Nennala/CoopRobot/Spec/Terrain.odt

Spécification Epreuve

Objectifs

Chaque robot doit :

- Se repérer et repérer son coéquipier
- Rejoindre son coéquipier
- Traverser avec son coéquipier la zone de passage afin de valider l’épreuve

Terrain de jeu (80 * 80 cm)

Robot 1

Robot 2

Obstacle

Zone de passage
