Nennala/CoopRobot/Spec/coop robots.odt

Coopération de robots

Réaliser 2 robots sumo et les faire collaborer pour remplir une tache trop difficile pour 1 seul. Les robots doivent être identiques et doivent être équipés de capteurs afin d’appréhender leur environnement. Ils doivent pouvoir communiquer entre eux pour élaborer et exécuter leur stratégie.

# Intérets

Ce projet peut être vu comme un point de départ de projets sur l’étude de comportements collectifs (collaboration, competition). Des projets avec plus de robots peuvent émerger, comme la cartographie, des jeux (sports) où autre.

# Compétences principales mise en œuvre

- Robotique : Réalisation des robots (méca, installation des capteurs/actionneurs...)
- Informatique embarquée : programmation C des capteurs/actionneurs/communication
- Intelligence artificielle : Implémentation C d’un unique algorithme de collaboration
- Automatique : Régulation (ou estimation) de la position

# Cahier des charges

1. La première étape est de définir la mission à réaliser (exemple : pousser une caisse, tendre une corde, synchroniser des événements)
2. Designer les robots en conséquences : lister les actionneurs/capteurs nécessaires
3. Réalisation des 2 robots
4. Implémentation de l’algorithme unique à implémenter dans les robot
5. Intégration et tests
6. Réaliser une documentation permettant à d’autres de comprendre/reproduire/améliorer le projet

# Proposition de gestion de projet

Les taches 1 et 2 doit être réalisées en équipe. Puis les taches 3 et 4 peuvent être réalisées en parallèle car elles sont toutes les deux nécessaire pour la tache 5. La tache 6 doit être ouverte du début à la fin.

# Points évalués

- L’approche (démarche, organisation) : 40 %
- Le résultat final : 40 %
- La documentation : 20 %

# Pistes d’amélioration

- Améliorer les robots : précision des capteurs/actionneurs, performance/robustesse de l’automatique
- Etude d’autres stratégies, avec plus de robots par exemple
- Ajout d’un robot perturbateur
