Nennala/CoopRobot/Spec/présentation_projet.odt

Coopération de robots

## Système centralisé/décentralisé

Dans un système centralisé, un ordinateur calcule toutes les actions de chaque exécuteur (robot) et les transmets à ces derniers qui les exécutent. À l'inverse, dans un système décentralisé c'est le comportement de chaque robot qui défini le comportement global.

Nous ne somme pas dans le cas d'un système centralisé car chaque robot participe à la réflexion et reste libre du choix de ses actions. Absence de relation maître-esclave. Nous ne somme pas non plus dans un système décentralisé car ce n'est pas le comportement de nos robots qui définis un comportement global car il n'y a pas de comportement global attendu. Nous somme dans un cas de coopération, chaque robot prend les décisions le concernant lui même mais il tiens compte de l'état de son coéquipier.

## Mise en place de la coopération

Sur notre terrain la coopération intervient lors de la détermination de la position. Nous avons en effet deux robots évoluant sur une même surface, ils vont donc se gêner l'un l'autre car ils peuvent fausser les mesurer de leur coéquipier, cependant on peut aussi voir cela comme un avantage :

### Trois utilisations possibles de la communication

- Mise en commun des capteurs → faire mesurer de la vitesse d'un robot par un autre
- Mise en commun des actionneurs → déplacement d'un robot afin de valoriser l'information du second
- Mise en commun des informations → échange de positionnement, avancement des objectifs

## Mise en place de la coopération : 3 possibilités

1 – Le robot 1 bouge, détermine sa position, puis le robot 2 bouge, détermine sa position, alors les deux robots se rejoignent et réalisent l'action commune.

  - Mise en commun des informations

2 – Le robot 1 bouge, détermine sa position, détermine la position du robot 2 puis les deux réalisent l'action commune

  - Mise en commun des capteurs

3 – Les deux robots se déplacent en même temps, déterminent leur position et coopèrent afin de vérifier ce positionnement. Puis ils réalisent l'action commune.

  - Mise en commun des informations
  - Mise en commun des capteurs

# Cahier des charges

1. La première étape est de définir la mission à réaliser (exemple : pousser une caisse, tendre une corde, synchroniser des événements)
2. Designer les robots en conséquences : lister les actionneurs/capteurs nécessaires
3. Réalisation des 2 robots
4. Implémentation de l’algorithme unique à implémenter dans les robot
5. Intégration et tests
6. Réaliser une documentation permettant à d’autres de comprendre/reproduire/améliorer le projet

# Compétences principales mise en œuvre

8. Robotique : Réalisation des robots (méca, installation des capteurs/actionneurs...)
9. Informatique embarquée : programmation C des capteurs/actionneurs/communication
10. Intelligence artificielle : Implémentation C d’un unique algorithme de collaboration
11. Automatique : Régulation (ou estimation) de la position
