Nennala/CoopRobot/Spec/spécification.odt

Spécification

Coopération de robots

L’objectif de ce projet est de créer deux robots capables de coopérer pour venir à bout d’une épreuve définie qui oblige une coopération.

Le robot doit être capable de :

- Se déplacer
- Se repérer dans l’espace
- Communiquer avec son coéquipier
- Prendre une décision en concertation avec son coéquipier

# Spécification matérielle du robot :

Les châssis des robots sont fournis au projet, ainsi que les composants et capteurs. Les robots doivent être identiques en conception matérielle.

## Micro-contrôleur :

Pour ce projet nous utiliserons deux cartes STM32F303K8 comme micro-contrôleurs pour nos robots, ces cartes permettent un encombrement minimal sur le robot et fournissent suffisamment d’entrées-sorties pour nos différents capteurs.

## Déplacement :

Le déplacement est assuré par des moteurs à courant continus. Un driver moteur (nom du driver) fait l'interface de puissance.

Pour pivoter il est également important de connaître son orientation. En effet sans orientation connue notre robot est sensible aux perturbations externes. Nous utiliserons donc ici un magnétomètre pour connaître l’orientation de notre robot.

## Repérage dans l’espace :

Ici deux capteurs SHARP seront utilisés pour mesurer les distances. L’un d’entre eux sera fixé sur un servomoteur fixé sur le châssis pour pouvoir balayer l’environnement et l’autre sera fixe, dirigé vers l’avant du robot.

## Communication :

Pour la communication, le protocole UART sera utilisé mais la communication filaire est trop contraignante sur une épreuve (risques d’accrocher les fils dans le décors et risque de perturbations avec la longueur du fil) ce sont donc deux modules radio à sens unique qui seront utilisés.

# Spécification logicielle :

La conception logicielle est séparée en trois parties :

- Une couche bas niveau avec des fonctions permettant de déplacer le robot et de récupérer les valeurs des capteurs
- Un protocole de communication gérant le transfert de données de manière fiable.
- Une couche haut niveau définissant le comportement du robot.

La couche haut niveau se servira des fonctions des deux autres niveaux pour définir des réactions pour le robots en fonction des données matérielles.

## Couche bas niveau:

Le but de cette couche est de créer des fonctions élémentaires de déplacement à l’aide de capteurs et des timers pour avancer et tourner, ainsi qu’une fonction renvoyant une structure contenant les valeurs des capteurs la plus à jour possible (100 fois par secondes).

Fonctions élémentaires pour le déplacement :

- avancer de 10 cm
- reculer de 10 cm
- tourner de 90° à gauche
- tourner de 90° à droite

## Couche communication :

Cette couche doit gérer indépendamment du reste la communication entre les deux robots, elle définie donc la taille des trames envoyées et le protocole de sécurité des données pour vérifier l’intégrité de celui-ci. Il y a plusieurs choix technologiques possibles que nous devons tester en fonction de la longueur de la trame :

- bit de parité
- XOR
- Checksum

## Couche IA :

Cette couche définie la connaissance de l’épreuve du robot ainsi que la façon que celui-ci aura de quadriller son environnement. Cette couche utilise toutes les fonctions des couches inférieure et donc se positionne en couche de haut niveau. Elle permet de créer les déplacement du robots en fonctions de son environnement, de définir comment celui-ci va repérer où est le deuxième robot et également quelle méthode de prise de décision ceux-ci vont utiliser.

Quadrillage de la zone :

On utilise le fait que les fonctions élémentaires font avancer de 10 cm pour quadriller la zone en une multitude de carrés de 10*10 cm² pour établir une carte de l’épreuve.

Repérage du deuxième robot :

Les robots vont se déplacer en balayant la zone en cherchant un déplacement anormal qui ne soit pas de 10 cm, s’ils ne se trouvent toujours pas, il vont tourner pour chercher dans une autre direction.

Prise de décision :

Pour la prise de décision les robots vont utiliser un tirage pseudo aléatoire et comparer les numéros obtenus, celui qui a le numéro le plus grand deviens prioritaire et indique à l’autre qu’il est prioritaire.
