Nennala/CoopRobot/Dossier technique/soutenance.odp

## Coopération de robots

Thibault Vernay, Victor Cazaux, Daphné Porteries

## Objectifs

Robots capables de :

- Se déplacer
- Se repérer dans l’espace
- Communiquer avec un coéquipier
- Prendre une décision en concertation

## Présentation de l’épreuve

Robot 1

Robot 2

Obstacle

Zone de passage

## Organisation interne

- Mise en place d’un dépôt GitHub
- Schéma d’organisation :

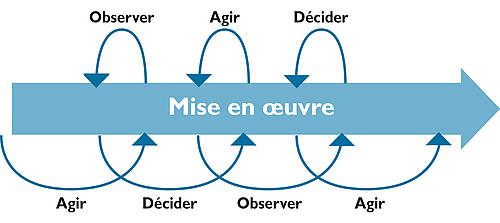
[picture p15: figure]

## Premier jet

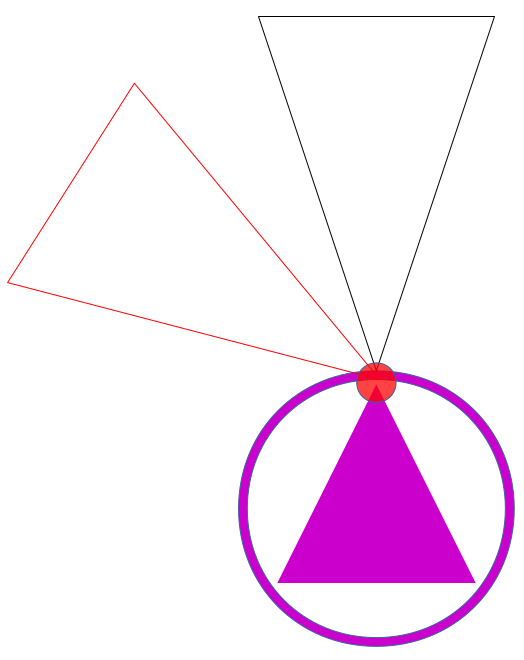
[picture p16: figure]

O

N

E

S

## LE robot

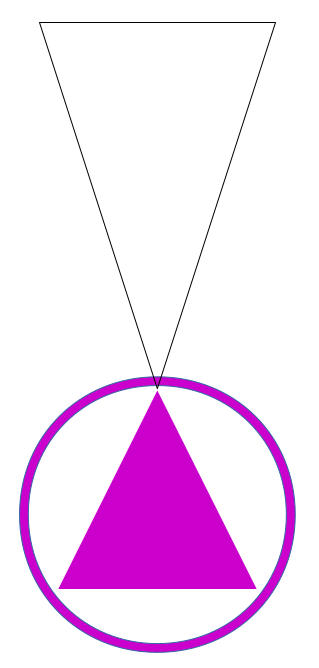
[picture p17: figure]

## Spécification matérielle

- Matériel à disposition :
- Châssis imprimé 3D
- Moteurs courant continu
- Servomoteur

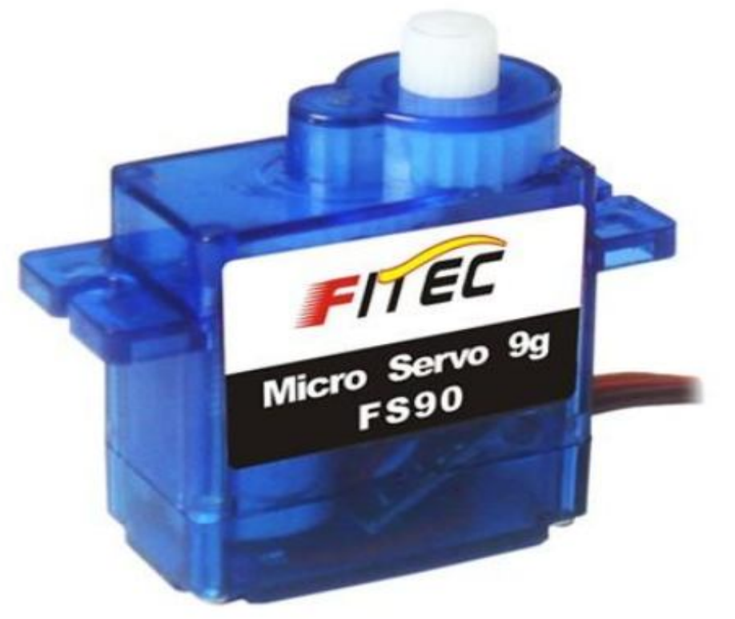
[picture p18: figure]

## Spécification matérielle

- Repérage dans l’espace :
- Magnétomètre
- Capteurs IR

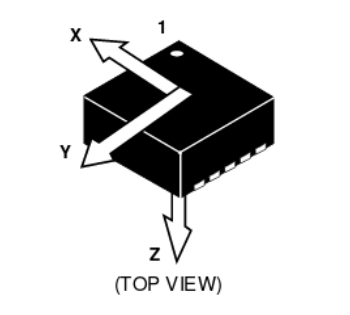
[picture p19: figure]
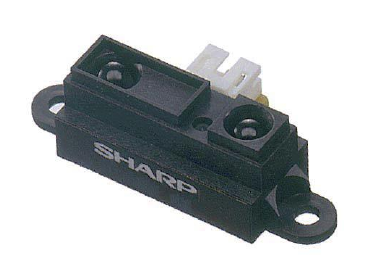
[picture p20: figure]

## Spécification matérielle

- Communication :
- UART filaire
- Module radio ?

## Spécification matérielle

- Montage d’alimentation :

Vin

5V

GND

C1

C2

C3

C4

## Le micro-contrôleur

- Nucléo :

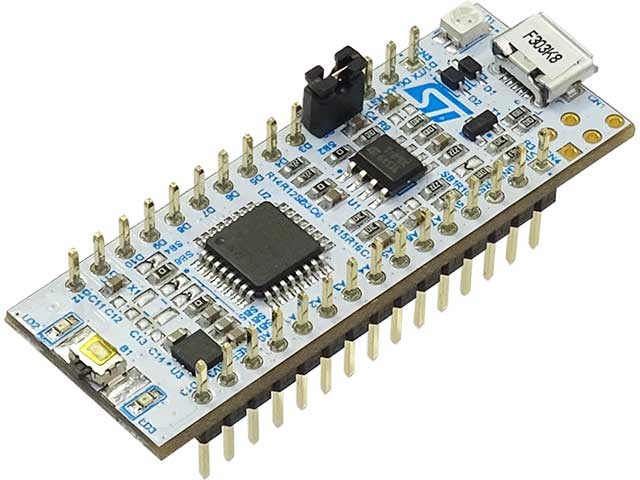
[picture p21: figure]

STM32F303K8

## Présentation de la HAL

- Hardware Abstraction Layout

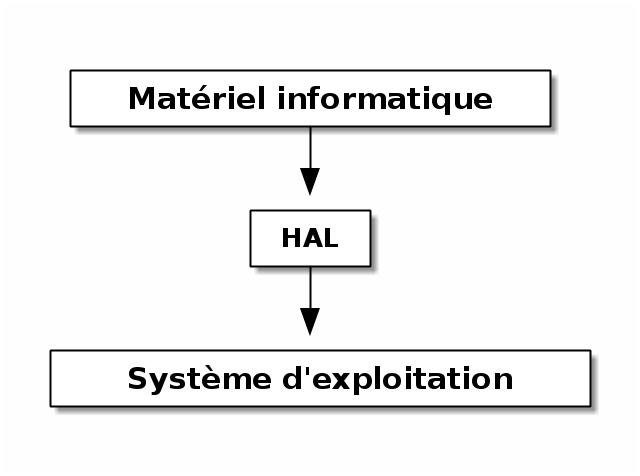
[picture p22: figure]

## Spécification logicielle

- Découpage du projet

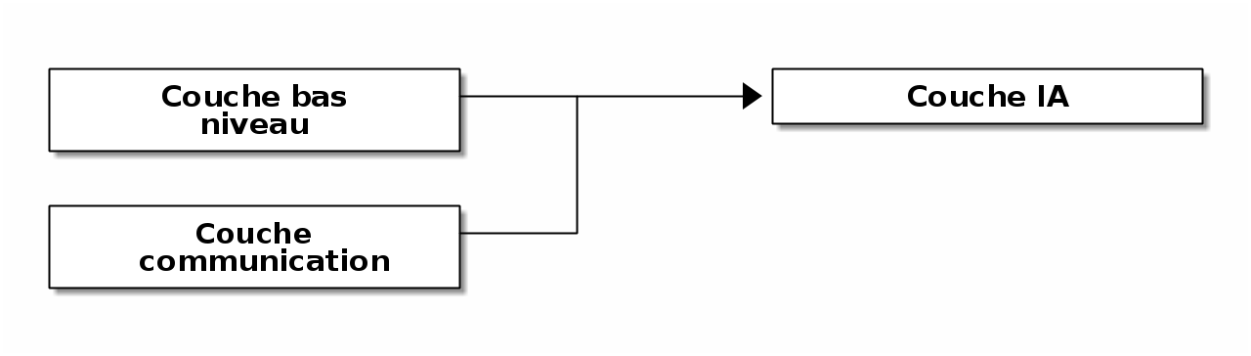
[picture p23: figure]

## Étude des composants

- Moteurs courant continu :
- Driver moteur TB6612FNG

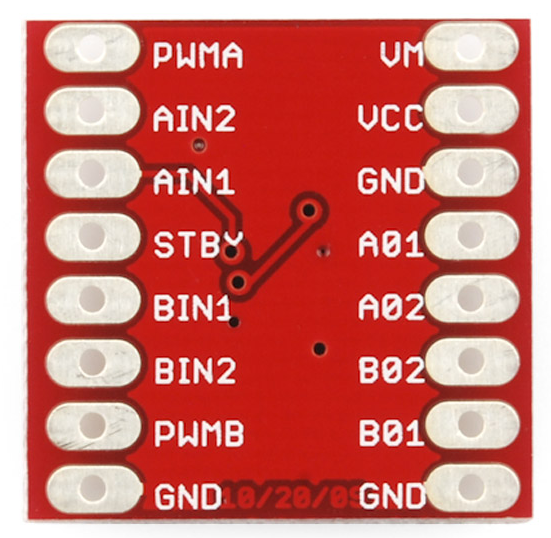
[picture p24: figure]

## Étude logicielle

- Moteurs

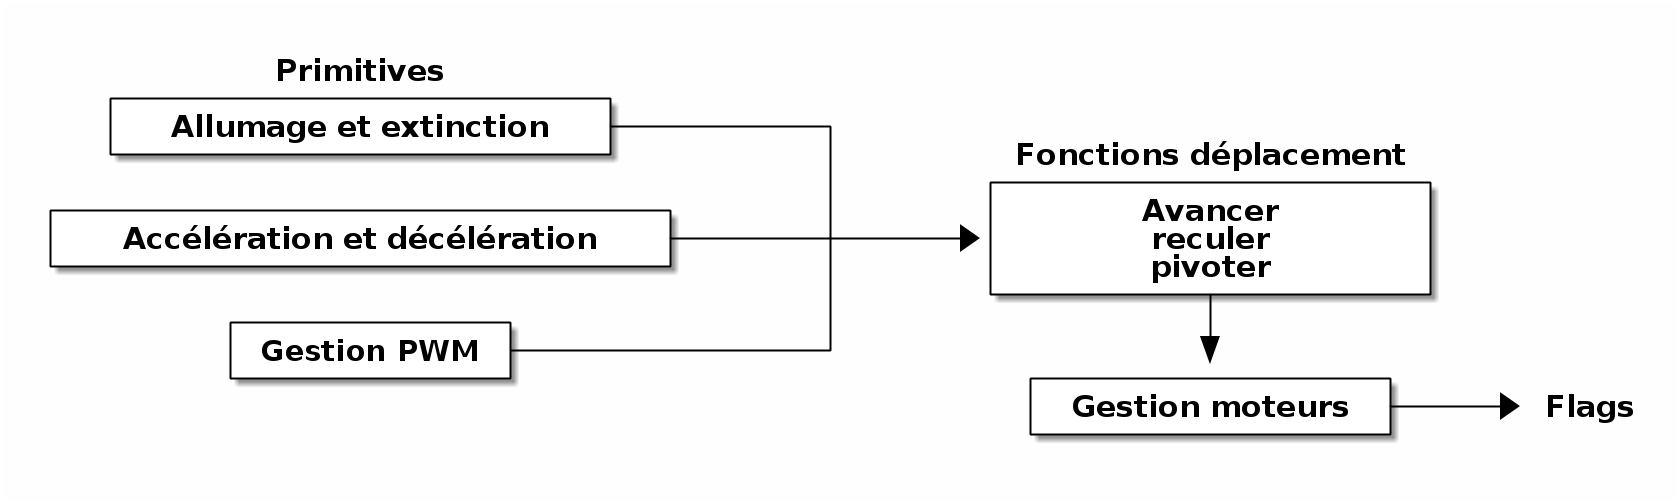
[picture p25: figure]

## Étude des composants

- Capteur IR :
- Capteur de distance à LED infrarouges de 10 cm à 80 cm


## Étude logicielle

- ADC avec interruptions :

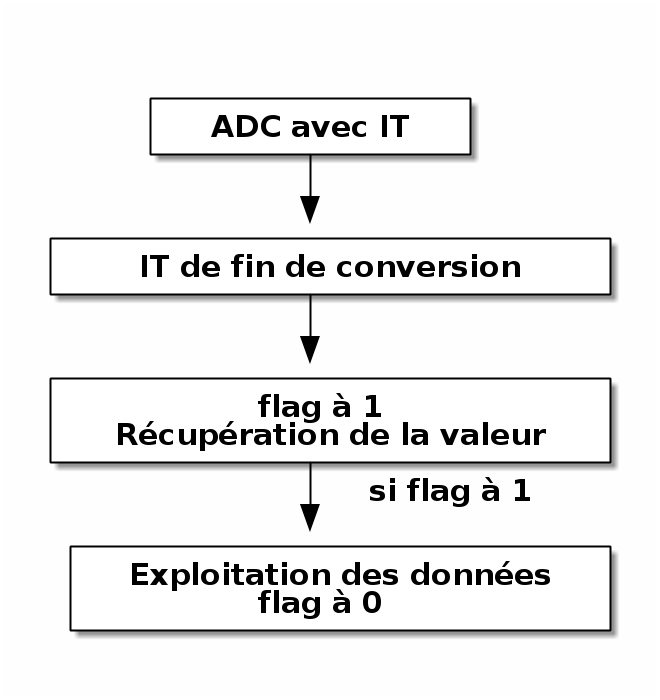
[picture p26: figure]

## Étude logicielle

- Protocole d’envoi de données :

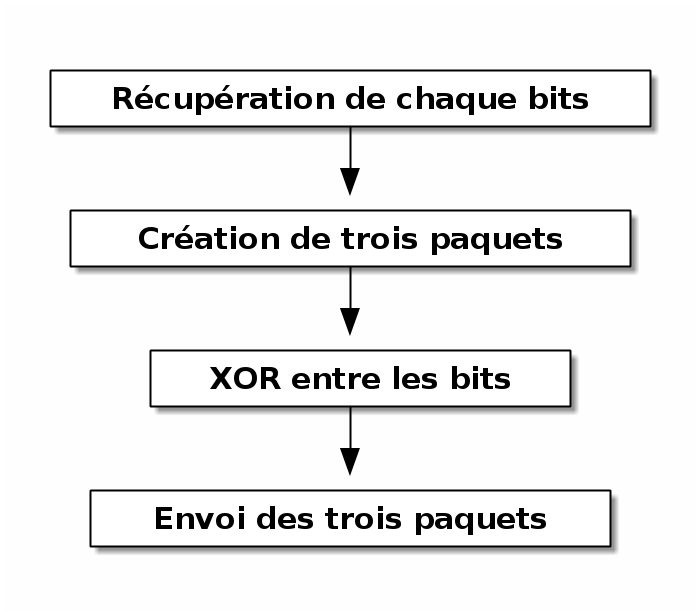
[picture p27: figure]

## Étude logicielle

- Protocole de réception de données :

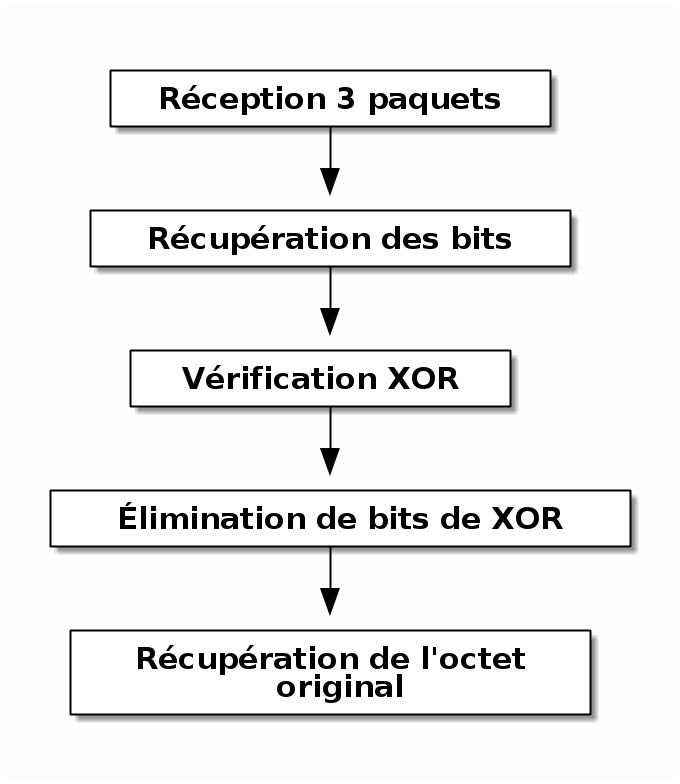
[picture p28: figure]

## Présentation FreeRTOS

- OS temps réel
- Parallélisation des processus
- Nombre de tâches limité par le matériel

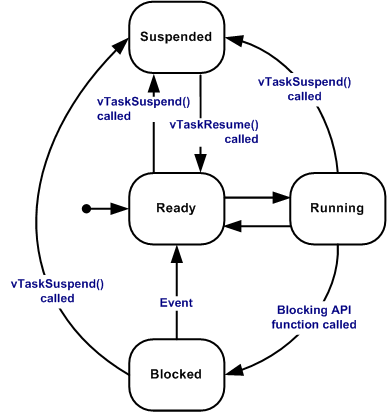
[picture p29: figure]

## Gestion de la mémoire

- Allocation de la stack
- Gestion du Heap

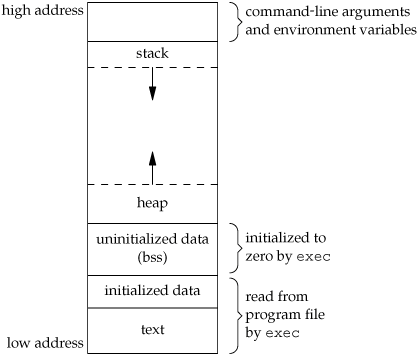
[picture p30: figure]

## Utilisation du FreeRTOS

Moteurs_task

IA_task

Flag_distance = 0

Flag_deplacement_fini = 0

## Utilisation du FreeRTOS

Moteurs_task

Déplacement de 3

Attendre la fin du

Déplacement

IA_task

Flag_distance = 0

Flag_deplacement_fini = 0

## Utilisation du FreeRTOS

Moteurs_task

Déplacement de 2

Attendre la fin du

Déplacement

IA_task

Flag_distance = 0

Flag_deplacement_fini = 0

## Utilisation du FreeRTOS

Moteurs_task

Déplacement de 2

Attendre la fin du

Déplacement

IA_task

Flag_distance = 2

Flag_deplacement_fini = 0

## Utilisation du FreeRTOS

Moteurs_task

Fais avancer le robot de 1

Décrémente le flag_distance de 1

Déplacement de 3

Déplacement de 2

Attendre la fin du

Déplacement

IA_task

Flag_distance = 2

Flag_deplacement_fini = 0

## Utilisation du FreeRTOS

Moteurs_task

Fais avancer le robot de 1

Décrémente le flag_distance de 1

Déplacement de 3

Déplacement de 2

Attendre la fin du

Déplacement

IA_task

Flag_distance = 1

Flag_deplacement_fini = 0

## Utilisation du FreeRTOS

Moteurs_task

Fais avancer le robot de 1

Décrémente le flag_distance de 1

Déplacement de 3

Déplacement de 2

Attendre la fin du

Déplacement

IA_task

Flag_distance = 1

Flag_deplacement_fini = 0

## Utilisation du FreeRTOS

Moteurs_task

Fais avancer le robot de 1

Décrémente le flag_distance de 1

Déplacement de 3

Déplacement de 2

Attendre la fin du

Déplacement

IA_task

Flag_distance = 0

Flag_deplacement_fini = 0

## Utilisation du FreeRTOS

Moteurs_task

Fais avancer le robot de 1

Décrémente le flag_distance de 1

Déplacement de 3

Déplacement de 2

Attendre la fin du

Déplacement

IA_task

Flag_distance = 0

Flag_deplacement_fini = 1

## Utilisation du FreeRTOS

Moteurs_task

Fais avancer le robot de 1

Décrémente le flag_distance de 1

Déplacement de 3

Déplacement de 3

Attendre la fin du

Déplacement

IA_task

Flag_distance = 2

Flag_deplacement_fini = 0

## Prise de décision

- Simulateur
- Pas totalement implémentée

## IA

## IA

## IA

## IA

Je ne suis pas dans un coin

## IA

## IA

## IA

## IA

## IA

Je suis dans un coin

## IA

Je suis dans un coin

## IA

Je suis dans un coin

## IA

N

O

E

S

## IA

RDV au Nord

N

O

E

S

OK, j’arrive

## IA

N

O

E

S

## IA

N

O

E

S

## IA

N

O

E

S

## IA

N

O

E

S

## IA

N

O

E

S

FINI !

## IA

## IA

## IA

## IA

Je suis au coin N-E

Je suis au coin N-E

## IA

Je te vois !

Je ne te vois pas !

## IA

Je suis dans le coin

## Problèmes rencontrés

- Complexification inutile
- Prise en main des outils
- Pas de magnétomètres

## Conclusion

- Compétences acquises
- Adaptation
- Travail de groupe
- Répartition des taches
