Nennala/CoopRobot/Spec/robot_final.pdf

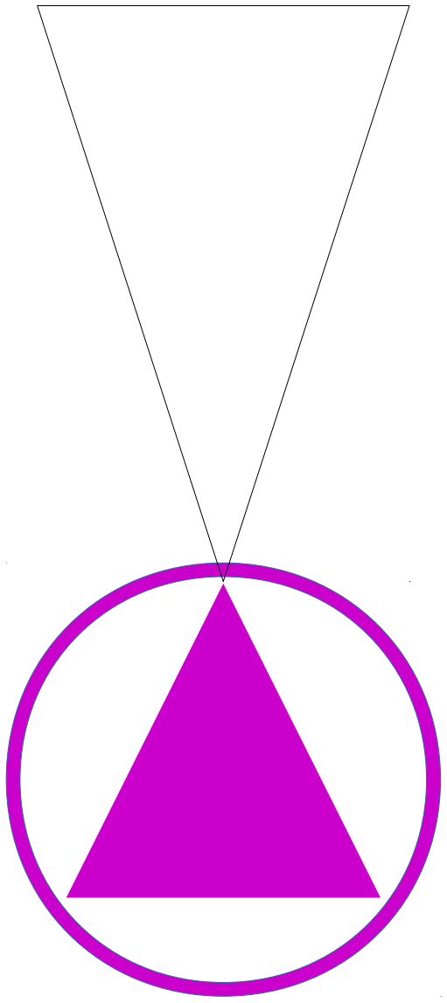
[picture p31: figure]
