Nennala/CoopRobot/Spec/robot_initial.pdf

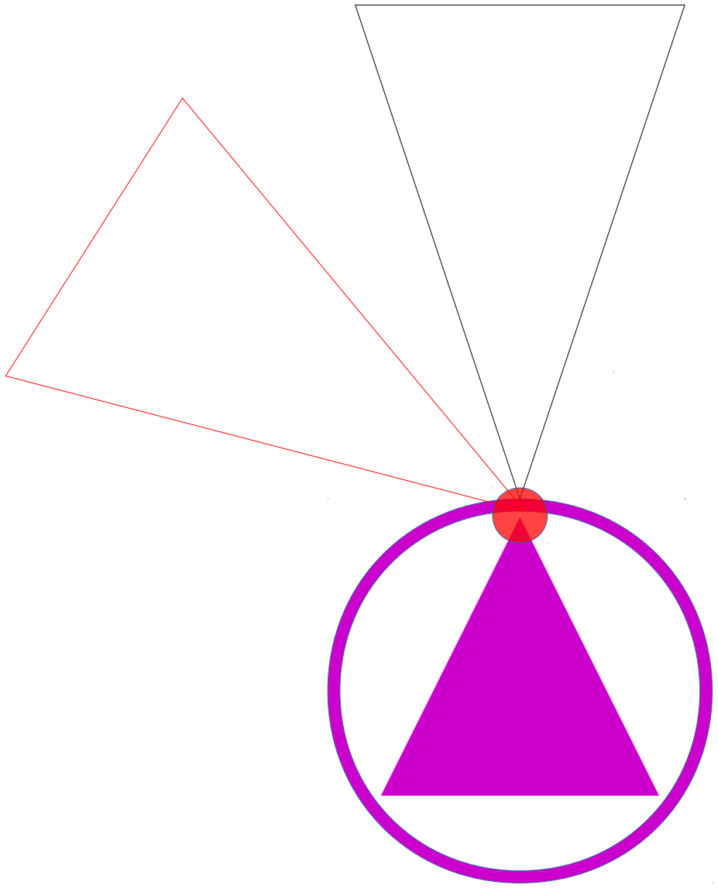
[picture p32: figure]
