Nennala/CoopRobot/Spec/Liste-miniprojets-2A.ods

Liste élèves 2A | Sujet 1
ADAMCZAK Nowen | Égaliseur Audio
BEAUTHIAS--VECCHIATO Antonin | Panneau solaire
BEYNEIX Alexis | Serre automatisée
BLANC-DOUGADOS Oriane | Panneau solaire
BLIN Alan | Panneau solaire
BOLLARD Guillaume | Panneau solaire
CAZAUX Victor | coop robot
COHENNEC Clara | Robot coureur
COSTAGLIOLA Guillaume | Robot coureur
CUGNET Théophile | Robot coureur
DAL PRA Etienne | Serre automatisée
DEMILLY Clément | Serre automatisée
DERANSART Erwan | Coop robot (IR)
DESBOS Luc | Serre automatisée
DREVET Elie | seagway
ECK Rémy | Asservissement balle
JOUD Raphaël | Serre automatisée
LE POURSOT Axelle | Seagway
LEROY Benjamin | Seagway
LONGERE Arthur | seagway
LOPES DA SILVA Thomas | Égaliseur Audio
MAIRE William | Égaliseur Audio
NALPAS-RIBIER Noémie | Panneau solaire
NGUYEN Jessica | seagway
NICOLUSSI CASTELLAN Guillaume | IR
PORTERIES Daphné | Coop robot
RIVIERE Anthony | Panneau solaire
ROSNOBLET Mathieu | Égaliseur Audio
SAHIN Ihsan | Calculatrice (IR)
SIMUNOVIC Boris | Calculatrice
THIRION Adrien | Serre automatisée
TISSOT Pierre-Antoine | Seagway
VERNAY Thibault | Coop robot
