Nennala/CoopRobot/Doc/f303k8.png

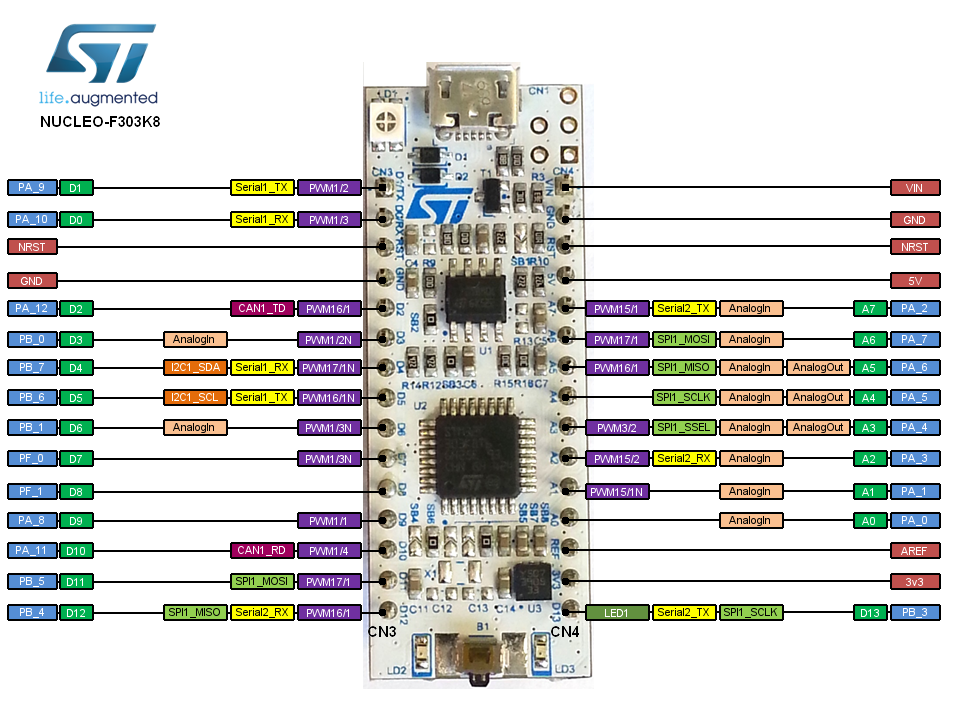
Doc/f303k8.png
