Nennala/CoopRobot/Dossier technique/Ressources/picture.jpg

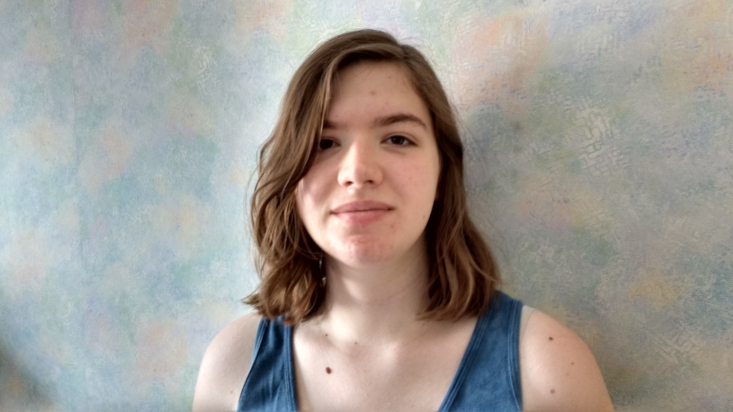
Dossier technique/Ressources/picture.jpg
