Nennala/CoopRobot/Dossier technique/Ressources/tab_driver.png

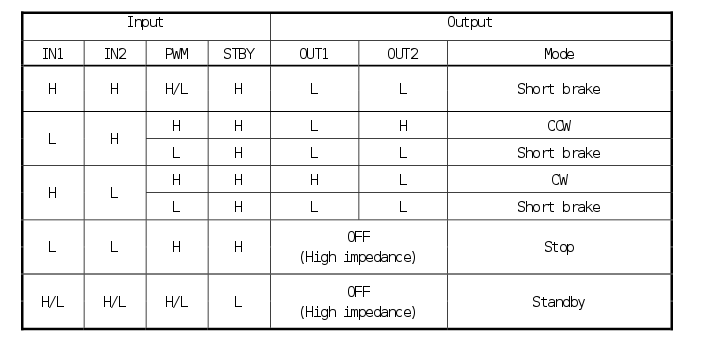
Dossier technique/Ressources/tab_driver.png
