Nennala/CoopRobot/Spec/Ia_dev1.jpg

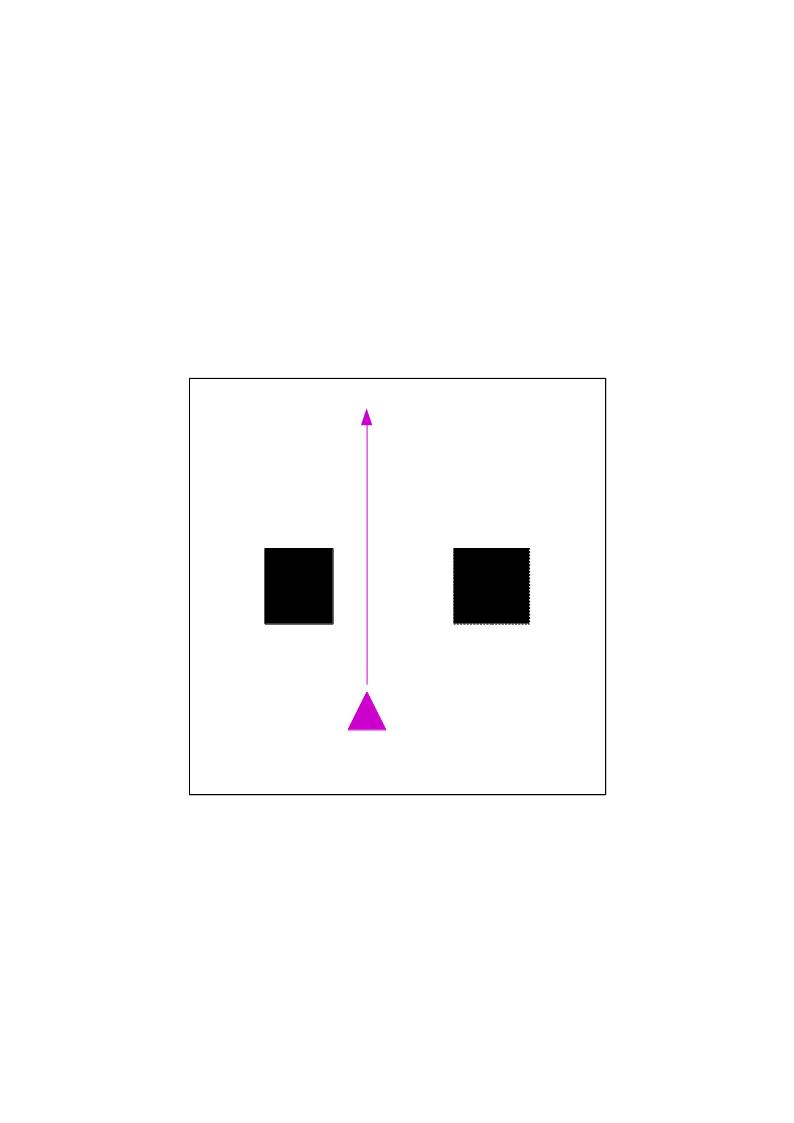
Spec/Ia_dev1.jpg
