Nennala/CoopRobot/Spec/Ia_dev10.jpg

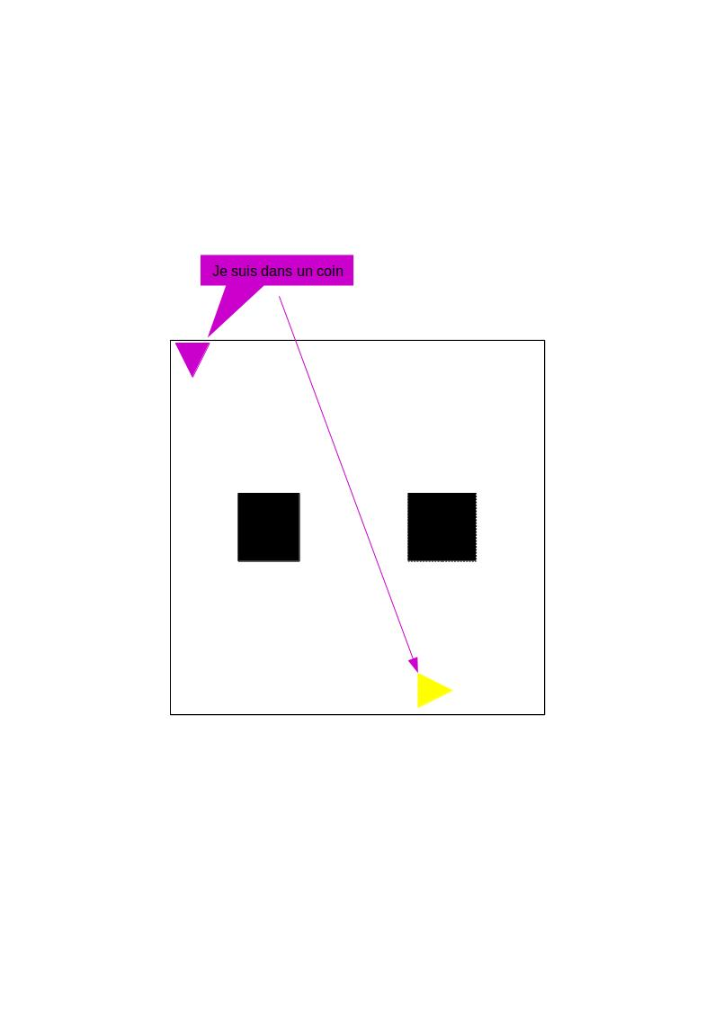
Spec/Ia_dev10.jpg
