Nennala/CoopRobot/Spec/Ia_dev13.jpg

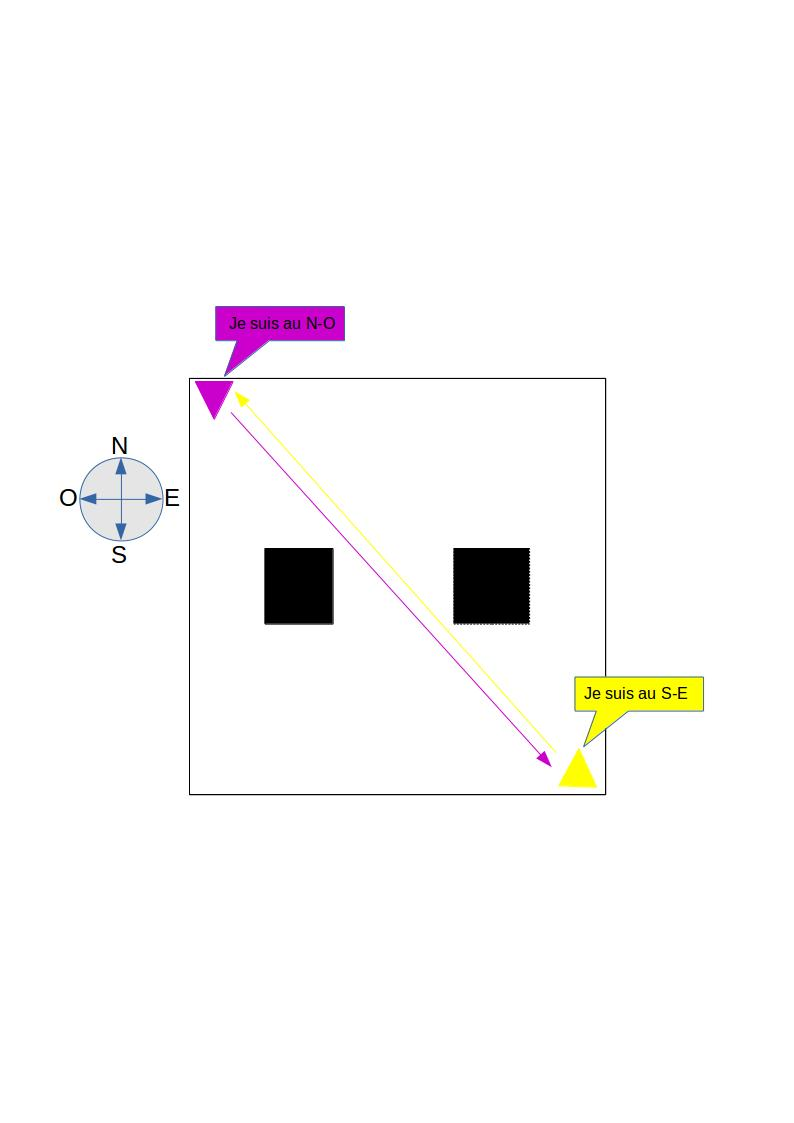
Spec/Ia_dev13.jpg
