Nennala/CoopRobot/Couche bas niveau/putain_de_test_2/putain_de_test_2.txt

Configuration	putain_de_test_2
STM32CubeMX 	4.21.0
Date	06/19/2017
MCU	STM32F303K8Tx

PERIPHERALS	MODES	FUNCTIONS	PINS
ADC1	IN1 Single-ended	ADC1_IN1	PA0
SYS	TIM17	SYS_VS_tim17	VP_SYS_VS_tim17
USART2	Asynchronous	USART2_RX	PA15
USART2	Asynchronous	USART2_TX	PA2

Pin Nb	PINs	FUNCTIONs	LABELs
2	PF0 / OSC_IN*	RCC_OSC_IN	MCO
6	PA0	ADC1_IN1	sharp
8	PA2	USART2_TX	VCP_TX
23	PA13*	SYS_JTMS-SWDIO	SWDIO
24	PA14*	SYS_JTCK-SWCLK	SWCLK
25	PA15	USART2_RX	VCP_RX
26	PB3	GPIO_Output	led

SOFTWARE PROJECT

Project Settings : 
Project Name : putain_de_test_2
Project Folder : /home/daphne/Documents/Esisar/2A/Mini projet/CoopRobot/Couche bas niveau/putain_de_test_2
Toolchain / IDE : Makefile
Firmware Package Name and Version : STM32Cube FW_F3 V1.8.0

Code Generation Settings : 
STM32Cube Firmware Library Package : Copy all used libraries into the project folder
Generate peripheral initialization as a pair of '.c/.h' files per peripheral : No
Backup previously generated files when re-generating : No
Delete previously generated files when not re-generated : Yes
Set all free pins as analog (to optimize the power consumption) : No

Toolchains Settings : 
Compiler Optimizations : Balanced Size/Speed
