Nennala/CoopRobot/Couche bas niveau/adc_it/adc_it.ioc

Mcu.UserName=STM32F303K8Tx
PA0.GPIO_Label=sharp
PA0.Signal=ADC1_IN1
PA13.GPIO_Label=SWDIO
PA13.Signal=SYS_JTMS-SWDIO
PA14.GPIO_Label=SWCLK
PA14.Signal=SYS_JTCK-SWCLK
PA15.GPIO_Label=VCP_RX
PA15.Signal=USART2_RX
PA2.GPIO_Label=VCP_TX
PA2.Signal=USART2_TX
PB3.GPIO_Label=led
PB3.Signal=GPIO_Output
