Nennala/CoopRobot/(commit log)

2017-06-12 Ajout du dossier source pour la commande moteur et son projet QTCreator
2017-06-12 Ajout du projet Kicad pour le circuit électronique et la conception de la carte PCB
    [carte electronique.kicad_pcb, carte electronique.sch]
2017-06-13 voici ma version
    [Liste-miniprojets-2A.ods, carte electronique.kicad_pcb, carte electronique.sch]
2017-06-13 Ajout de la doc du magnétomètre HMC5883L
2017-06-13 Tests de la matinée
2017-06-13 ADC avec intéruptions et tranfert UART PC
2017-06-14 Fonction UART
2017-06-14 Ajout du dossier robot_test qui est un reboot de robot
    [main.c, main.h, robot_test.ioc]
2017-06-14 Tri des fichiers
    [Liste-miniprojets-2A.ods, carte electronique.kicad_pcb, carte electronique.sch]
2017-06-15 Finalisation du programme des moteurs
2017-06-15 Suppression des dossiers inutiles
2017-06-16 Ajout ADC dans une task dans robot_test
2017-06-16 Debug de RAM dans STM32CubeMx (HEAP SIZE = 9216)
2017-06-18 Tentative de faire fonctionner la DMA en vain
2017-06-18 Dernière mise à jour ADC DMA : échec
2017-06-19 Programme ADC fonctionnel et ajout de flag pour les fonctions moteur pour l'IA
2017-06-19 Routine robot validée (avec quasiment pas de décalages sur plusieurs routines)
2017-06-20 Intégration de l'ADC
2017-06-20 ajout uart
2017-06-20 Suppresion des fichiers qt en trop
2017-06-20 Corrections uart
2017-06-20 Intégration de l'UART au code principal
2017-06-20 moteur calibré, IA prise en compte de la présence de l'autre robot + se rend dans un coin
2017-06-21 Ajout des fonctions d'étalonnage de l'ADC et de flag
2017-06-21 tentative de merge
2017-06-21 Ajout de la spécification
2017-06-22 j'ai rajouté une partie de la partie IA au diapo, le reste arrive
2017-06-22 j'ai rajouté une partie de la partie IA
2017-06-22 il y avait une petite erreur
2017-06-25 Ajout de commentaires et entête pour la couche bas niveau
2017-06-25 mise à jour du dossier technique et fin des commentaires
2017-06-25 j'ai lu le compte-rendu,c'est trés bien, détaillé et précis comme il faut, j'ai juste une petite remarque dans l'introduction de la partie IA je ne conserverais que le premier paragraphe, le reste es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
2017-06-28 Rangement de fin de projet
